zacjiang77-ai/RSX-Drone-electrical/PDB.docx

PDB:

6S LiPo

22.2 V nominal

25.2 V fully charged

10,000 mAh

│

▼

Power Distribution

│

├──────────────► ESC 1 ──► Motor 1

├──────────────► ESC 2 ──► Motor 2

├──────────────► ESC 3 ──► Motor 3

└──────────────► ESC 4 ──► Motor 4

│

▼

Voltage Regulator / BEC

│

└── 5 V ──► Kakute H7

### What the PDB does

1. Power distribution
  - Connects the battery to multiple ESCs.
  - Keeps the high-current motor power wiring organized.
2. Voltage regulation
  - The battery might be, for example, a 4S LiPo: ~14.8 V nominal.
  - The flight controller may need 5 V, so the PDB can include a 5 V regulator/BEC.
3. Electrical protection( During demanding moments, such as takeoff and sharp maneuvers, motors draw high current. The PDB is designed to handle these high current loads using thick copper traces and secure connectors. These features help manage large power demands without overheating. )
  - Some PDBs include a fuse or current protection.
  - Some have reverse-polarity or over-current protection.
4. Current/voltage measurement
  - More advanced PDBs can measure battery voltage and current and send the information to the flight controller.
  - Current Shunt Resistors: PDBs integrate a highly precise, ultra-low resistance shunt (often measuring just a few milliohms) directly in series with the main power loop. By measuring the microscopic voltage drop across this resistor (applying Ohm's law: I=V/R ) and amplifying it via an ADC, the board sends real-time current consumption (mAh) to the flight controller.
