zacjiang77-ai/RSX-Drone-electrical/BOM.csv

Refs | Value | MPN | Footprint | Qty
C1,C6 | 100u / 50V | EEHZA1H101P | Capacitor_SMD:CP_Elec_10x10.5 | 2
C2,C3 | 10u / 50V | C3225X7R1H106K250AC | Capacitor_SMD:C_1210_3225Metric | 2
C4,C5 | 22u / 50V | C3225X7R1H226M250AC | Capacitor_SMD:C_1210_3225Metric | 2
C7 | 47n / 25V |  | Capacitor_SMD:C_0603_1608Metric | 1
C8 | 4.7u / 25V |  | Capacitor_SMD:C_0805_2012Metric | 1
C9 | 100n / 16V |  | Capacitor_SMD:C_0603_1608Metric | 1
C10 | 33n / 25V |  | Capacitor_SMD:C_0603_1608Metric | 1
C11 | 820p / 50V |  | Capacitor_SMD:C_0603_1608Metric | 1
J1 | 6S PDB INPUT | 1715721 | TerminalBlock_Phoenix:TerminalBlock_Phoenix_MKDS-1,5-2-5.08_1x02_P5.08mm_Horizontal | 1
J2 | TO JETSON | 1715721 | TerminalBlock_Phoenix:TerminalBlock_Phoenix_MKDS-1,5-2-5.08_1x02_P5.08mm_Horizontal | 1
L1 | 33uH | XGL1313-333MED | RSX_Jetson:Coilcraft_XGL1313 | 1
R1 | 10m / 1% | WSL2512R0100FEA | Resistor_SMD:R_2512_6332Metric | 1
R2 | 1R |  | Resistor_SMD:R_0603_1608Metric | 1
R3 | 232k / 0.1% |  | Resistor_SMD:R_0603_1608Metric | 1
R4 | 10.2k / 0.1% |  | Resistor_SMD:R_0603_1608Metric | 1
R5 | 100k / 1% |  | Resistor_SMD:R_0603_1608Metric | 1
R6 | 29.4k / 1% |  | Resistor_SMD:R_0603_1608Metric | 1
R7 | 8.06k / 1% |  | Resistor_SMD:R_0603_1608Metric | 1
U1 | LM70880RRXR | LM70880RRXR | RSX_Jetson:TI_RRX0029B | 1
