zacjiang77-ai/RSX-Drone-electrical/PDB.pdf

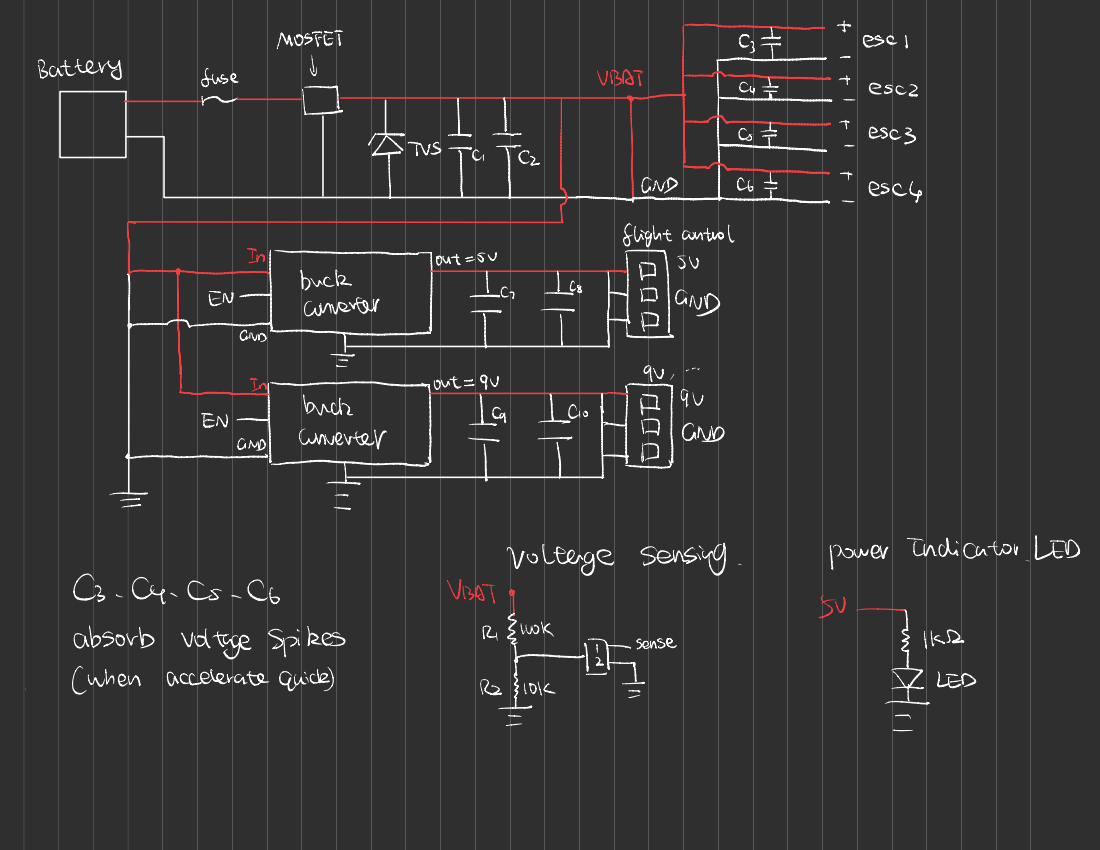
[picture p1: page 1]
. - nrainn ?; Ffi * fin
