zacjiang77-ai/RSX-Drone-electrical/RSX_Jetson_19V.kicad_pcb

## KiCad design RSX_Jetson_19V.kicad_pcb (2026-11-07)

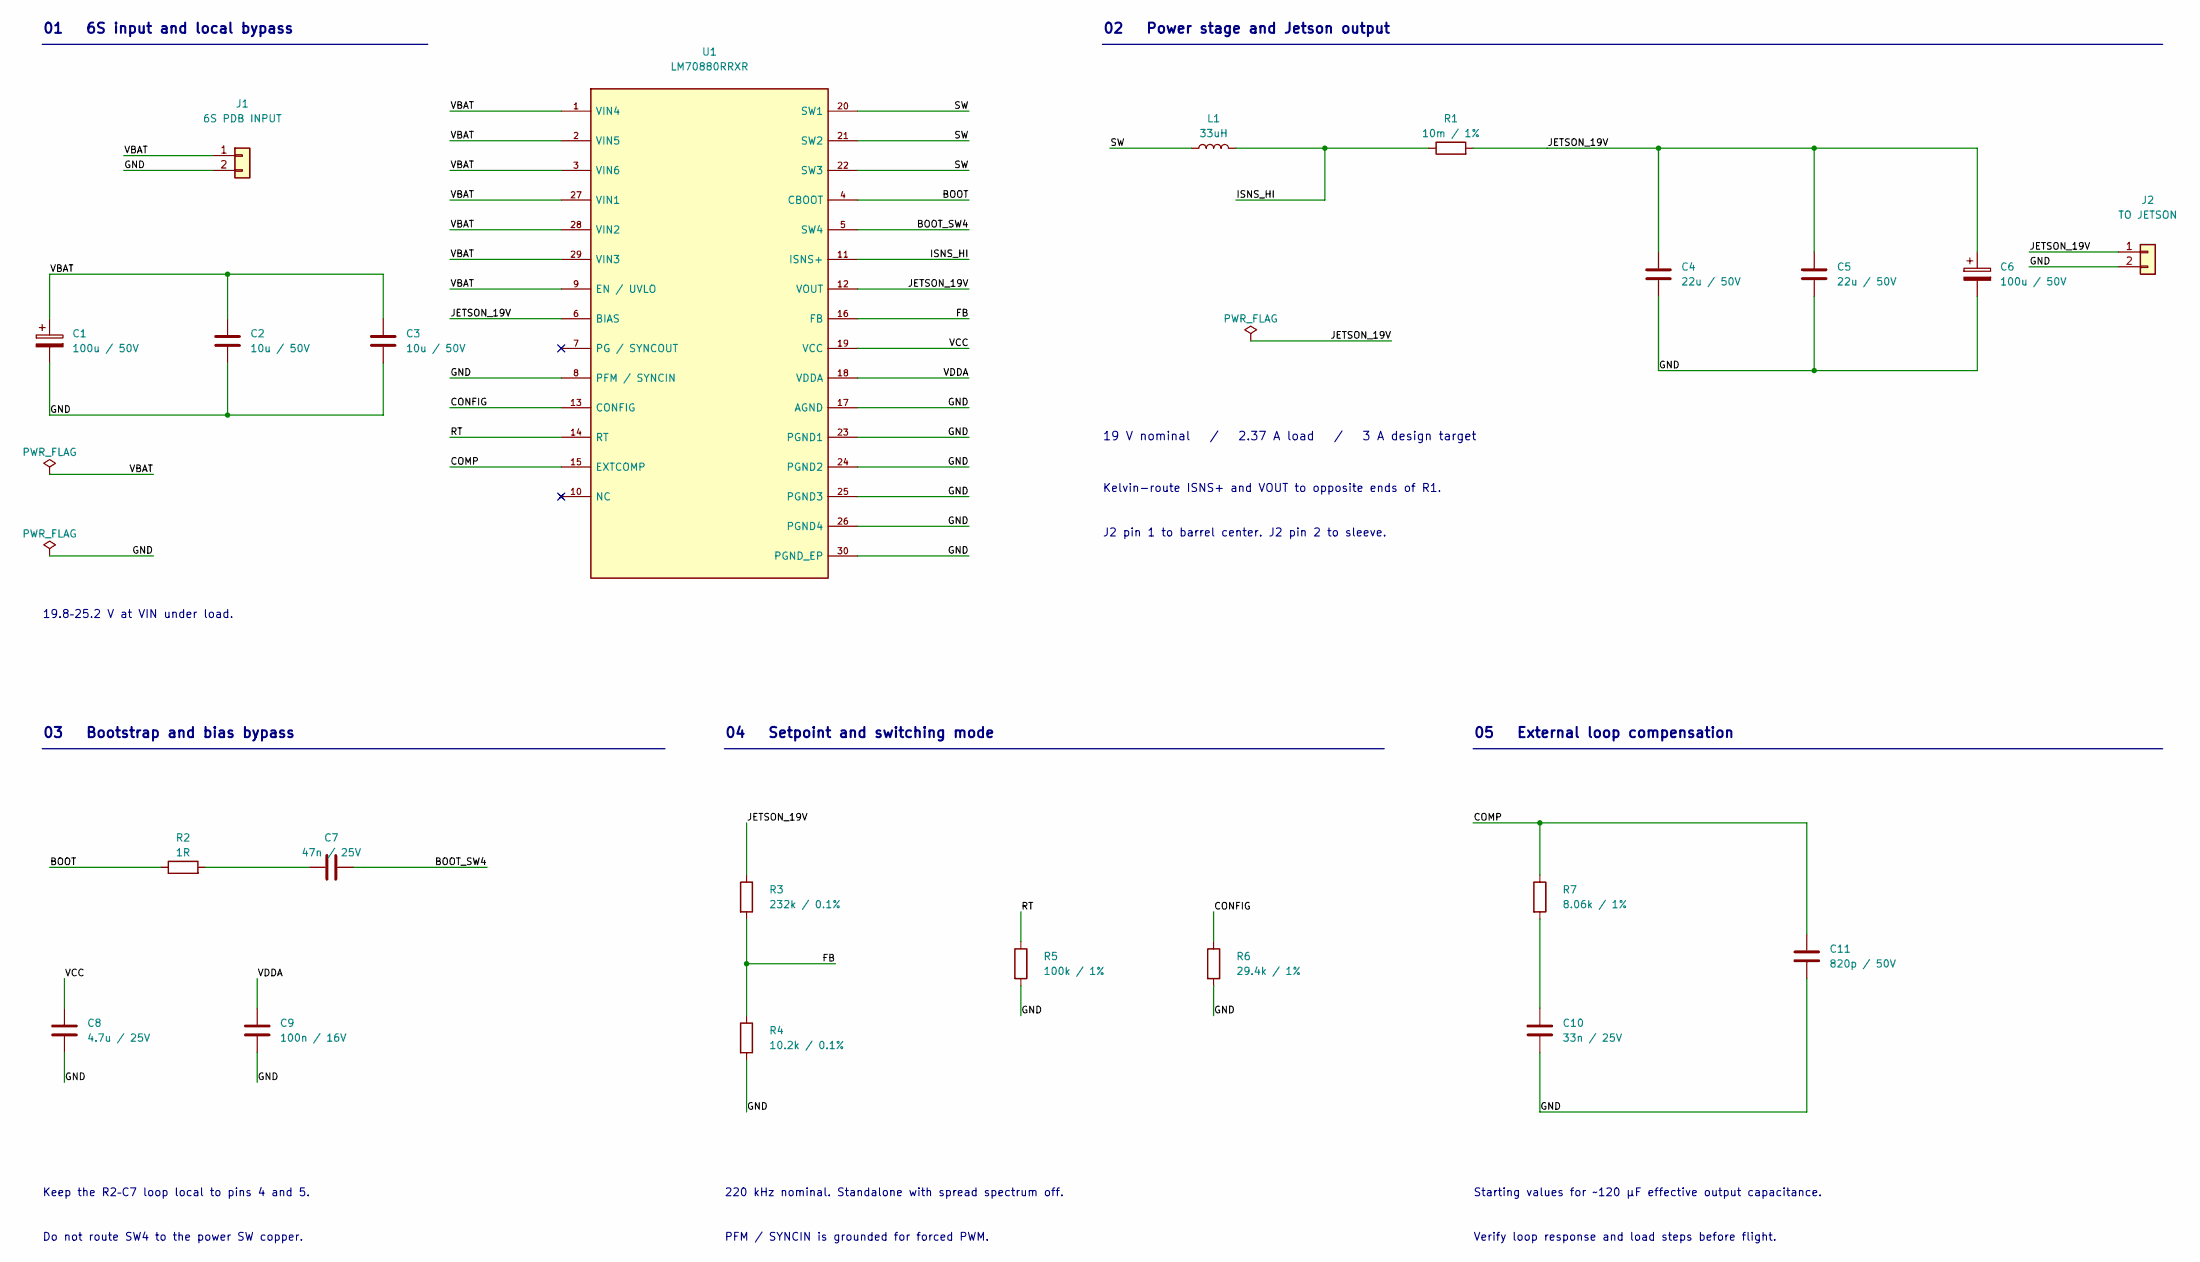
[picture p2: schematic RSX_Jetson_19V.kicad_sch, RSX | Jetson 19 V synchronous buck]

Parts:
C1, C6: 100u / 50V; CP_Elec_10x10.5; MPN EEHZA1H101P
C2, C3: 10u / 50V; C_1210_3225Metric; MPN C3225X7R1H106K250AC
C4, C5: 22u / 50V; C_1210_3225Metric; MPN C3225X7R1H226M250AC
C7: 47n / 25V; C_0603_1608Metric
C8: 4.7u / 25V; C_0805_2012Metric
C9: 100n / 16V; C_0603_1608Metric
C10: 33n / 25V; C_0603_1608Metric
C11: 820p / 50V; C_0603_1608Metric
J1: 6S PDB INPUT; TerminalBlock_Phoenix_MKDS-1,5-2-5.08_1x02_P5.08mm_Horizont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; MPN 1715721
J2: TO JETSON; TerminalBlock_Phoenix_MKDS-1,5-2-5.08_1x02_P5.08mm_Horizont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; MPN 1715721
L1: 33uH; Coilcraft_XGL1313; MPN XGL1313-333MED
R1: 10m / 1%; R_2512_6332Metric; MPN WSL2512R0100FEA
R2: 1R; R_0603_1608Metric
R3: 232k / 0.1%; R_0603_1608Metric
R4: 10.2k / 0.1%; R_0603_1608Metric
R5: 100k / 1%; R_0603_1608Metric
R6: 29.4k / 1%; R_0603_1608Metric
R7: 8.06k / 1%; R_0603_1608Metric
U1: LM70880RRXR; TI_RRX0029B; MPN LM70880RRXR

Connections:
/BOOT: R2.1, U1.4 (CBOOT)
/BOOT_SW4: C7.2, U1.5 (SW4)
/COMP: C11.1, R7.1, U1.15 (EXTCOMP)
/CONFIG: R6.1, U1.13 (CONFIG)
/FB: R3.2, R4.1, U1.16 (FB)
/GND: C1.2, C2.2, C3.2, C4.2, C5.2, C6.2, C8.2, C9.2, C10.2, C11.2, J1.2, J2.2, R4.2, R5.2, R6.2, U1.8 (PFM / SYNCIN), U1.17 (AGND), U1.23 (PGND1), U1.24 (PGND2), U1.25 (PGND3), U1.26 (PGND4), U1.30 (PGND_EP)
/ISNS_HI: L1.2, R1.1, U1.11 (ISNS+)
/JETSON_19V: C4.1, C5.1, C6.1, J2.1, R1.2, R3.1, U1.6 (BIAS), U1.12 (VOUT)
/RT: R5.1, U1.14 (RT)
/SW: L1.1, U1.20 (SW1), U1.21 (SW2), U1.22 (SW3)
/VBAT: C1.1, C2.1, C3.1, J1.1, U1.1 (VIN4), U1.2 (VIN5), U1.3 (VIN6), U1.9 (EN / UVLO), U1.27 (VIN1), U1.28 (VIN2), U1.29 (VIN3)
/VCC: C8.1, U1.19 (VCC)
/VDDA: C9.1, U1.18 (VDDA)
unnamed: C7.1, R2.2
unnamed: C10.1, R7.2

Notes on the sheet:
01 6S input and local bypass
19.8–25.2 V at VIN under load.
02 Power stage and Jetson output
19 V nominal / 2.37 A load / 3 A design target
Kelvin-route ISNS+ and VOUT to opposite ends of R1.
J2 pin 1 to barrel center. J2 pin 2 to sleeve.
03 Bootstrap and bias bypass
Keep the R2–C7 loop local to pins 4 and 5.
Do not route SW4 to the power SW copper.
04 Setpoint and switching mode
220 kHz nominal. Standalone with spread spectrum off.
PFM / SYNCIN is grounded for forced PWM.
05 External loop compensation
Starting values for ~120 µF effective output capacitance.
Verify loop response and load steps before flight.

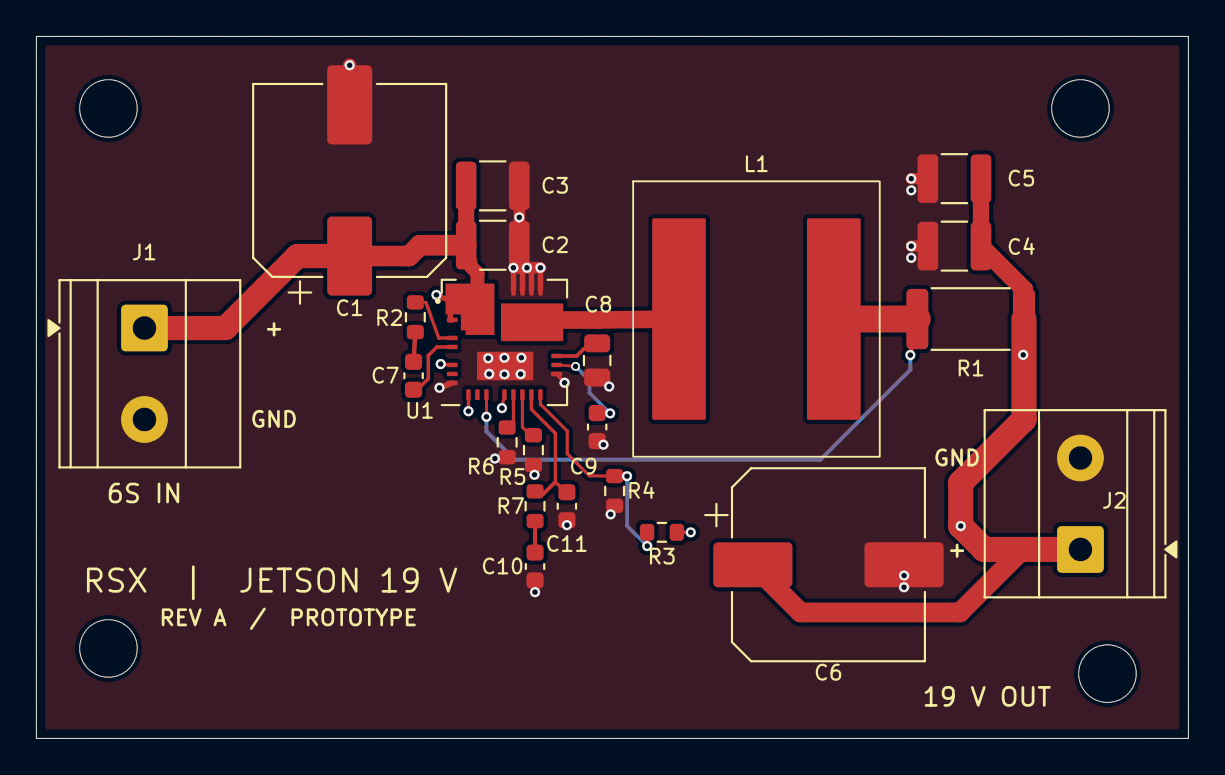
[picture p3: board RSX_Jetson_19V.kicad_pcb from above]

Board: 4 copper layers, 64.0 x 39.0 mm, 26 parts (0 on the bottom side), 15 nets.

Other parts of the board:
H1, H2, H3, H4: MountingHole_3.2mm_M3
